akito-W2525/HCK01_Workspace/(commit log)

2026-06-11 センサ，逆相ブレーキ単体テスト実装
2026-06-12 PID制御テストプログラム作成(ゲイン調整前)
2026-06-17 Revert "PID制御テストプログラム作成(ゲイン調整前)"
    This reverts commit d25afd22f895f2323e3832523e96396074c8fe41.
    [test_sensor.ino]
2026-06-17 PID制御テスト
2026-06-17 Update test_motor.ino
    PIDテストプログラム更新
2026-06-17 ゲイン調整完了，可変抵抗実装前
2026-06-17 可変抵抗導入
2026-06-17 楽器側テスト
2026-06-17 楽器側テスト修正
2026-06-17 楽器テスト修正ミス修正
2026-06-19 ゲイン決定，回転開始の不具合修正
2026-06-22 ノイズ対策50μ秒待機の追加，軽微な変更
2026-06-23 逆相ブレーキテスト
2026-06-23 指揮者側システム仮完成
2026-06-23 指揮者側 BPMの下限を80へ
2026-06-23 指揮者側システムでの輪唱実装
2026-06-24 楽器側実装
2026-06-24 楽器テストプログラム修正
2026-06-24 楽器テストプログラム文字化け修正
2026-06-24 1音に対する読みとり回数修正
2026-06-30 加速度センサでの目標BPM操作
2026-06-30 同期テスト
2026-07-01 1ループで終了に修正
2026-07-05 LEDマトリクスの絵
2026-07-06 楽器側LEDマトリクス実装
    演奏にあわせてカエルの絵が動くようにプログラム追加
2026-07-06 指揮者側LEDマトリクスBPM表示実装
2026-07-07 スリット読み取り回数調整
2026-09-18 READMEを追加し、.DS_StoreとCLAUDE.mdをGit管理から除外
2026-09-18 加速度センサ版にLEDマトリクスBPM表示を追加し、設定を本番版に合わせる
    - LEDマトリクスに現在のBPM（停止中は「---」）を表示
    - SLITS_PER_MEASURE 320→360、beatcount 40→45 を conductor_ex と揃える
    - 加速度のしきい値 650→590、起動ブースト PWM 250・1000ms に調整
2026-09-18 実機調整に合わせてパラメータとコメントを更新
    - 逆相ブレーキ時間 50→100ms（brake）
    - 起動ブースト PWM 100→250（conductor_ex）
    - 1拍のスリット数のコメントを 40→45 に修正（instrument）
    - テスト出力をBPMのみに簡略化（test_instrument）
    [brake.ino, conductor_ex.ino, instrument.ino, test_instrument.ino]
2026-09-18 READMEに写真・CAD図・評価結果・苦労したことを追加
